bilsef/Teensy4.1-RAMPS/README.md

# Teensy4.1-RAMPS
 A Teensy 4.1 to RAMPS adapter board
