bilsef/Teensy4.1-RAMPS/Gerber/teensy4_ramps-bom.xlsx

Comment | Desisgnator | Footprint | LCSSC Part # | Description
100uF, 35V | C1 | C_Elec_6.3x7.7 | C134792 (https://lcsc.com/product-detail/Aluminum-Electrolytic-Capacitors-SMD_Lelon-VES101M1VTR-0607_C134792.html/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) | 100uF ±20% 35V SMD,6.3x7.7mm
100nF | C2, C3 | C_0402 | C1525 (https://lcsc.com/product-detail/Multilayer-Ceramic-Capacitors-MLCC-SMD-SMT_SAMSUNG_CL05B104KO5NNNC_100nF-104-10-16V_C1525.html/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) | MULTILAYER CERAMIC CAPACITORS MLCC - SMD/SMT 100NF 16V 0402 ROHS
18pF | C4 | C_0402 | C1549 (https://lcsc.com/product-detail/Multilayer-Ceramic-Capacitors-MLCC-SMD-SMT_18pF-180-5-50V_C1549.html/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) | MULTILAYER CERAMIC CAPACITORS MLCC - SMD/SMT 18PF 50V 0402 ROHS
22uF, 16V | C5 | CP_Elec_4x5.3 | C134793 (https://lcsc.com/product-detail/Aluminum-Electrolytic-Capacitors-SMD_Lelon-VES220M1CTR-0405_C134793.html/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) | 22UF ±20% 16V SMD,4X5.3MM ALUMINUM ELECTROLYTIC CAPACITORS - SMD ROHS
1uF | C6 | C_0402 | C52923 (https://lcsc.com/product-detail/Multilayer-Ceramic-Capacitors-MLCC-SMD-SMT_SAMSUNG_CL05A105KA5NQNC_1uF-105-10-25V_C52923.html/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) | MULTILAYER CERAMIC CAPACITORS MLCC - SMD/SMT 1UF 25V 0402 ROHS
1A SMA | D1 | D_SMA | C260338 (https://lcsc.com/product-detail/Diodes-General-Purpose_SMC-Sangdest-Microelectronicstronic-Nanjing-S1A_C260338.html/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) | 50V 1A 1.1V @ 1A SMA DIODES - GENERAL PURPOSE ROHS
BAT60AE6327 | D2 | D_SOD-323 | C117485 (https://lcsc.com/product-detail/Schottky-Barrier-Diodes-SBD_Infineon-Technologies-BAT60AE6327_C117485.html/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) | 10V 3A 370MV @ 1A SOD-323 SCHOTTKY BARRIER DIODES (SBD) ROHS
4.7uH | L1 | L_4.7x5.2 | C477170 (https://lcsc.com/product-detail/Inductors-SMD_Gantong-GPSR0530-4R7M_C477170.html/?href=jlc-SMT) | 4.7UH ±20% 3A 46MΩ SMD,4.7X5.2X3.0MM INDUCTORS (SMD) ROHS
49.9K | R1, R2 | R_0402 | C25897 (https://lcsc.com/product-detail/Chip-Resistor-Surface-Mount_Uniroyal-Elec-0402WGF4992TCE_C25897.html/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) | CHIP RESISTOR - SURFACE MOUNT 49.9KOHMS ±1% 1/16W 0402 ROHS
9.53K | R3 | R_0402 | C96273 (https://lcsc.com/product-detail/Chip-Resistor-Surface-Mount_Uniroyal-Elec-0402WGF9531TCE_C96273.html/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) | CHIP RESISTOR - SURFACE MOUNT 9.53KOHMS ±1% 1/16W 0402 ROHS
AOZ1280CI | U2 | SOT-23-6 | C41240 (https://lcsc.com/product-detail/DC-DC-Converters_AOS_aoz1280ci_aoz1280ci_C41240.html/?href=jlc-SMT) | DC-DC CONVERTERS STEP-DOWN ADJUSTABLE 1 3V 26V 0.8V 1.2A SOT-23-6 ROHS
