bilsef/Teensy4.1-RAMPS/teensy4_ramps.pdf

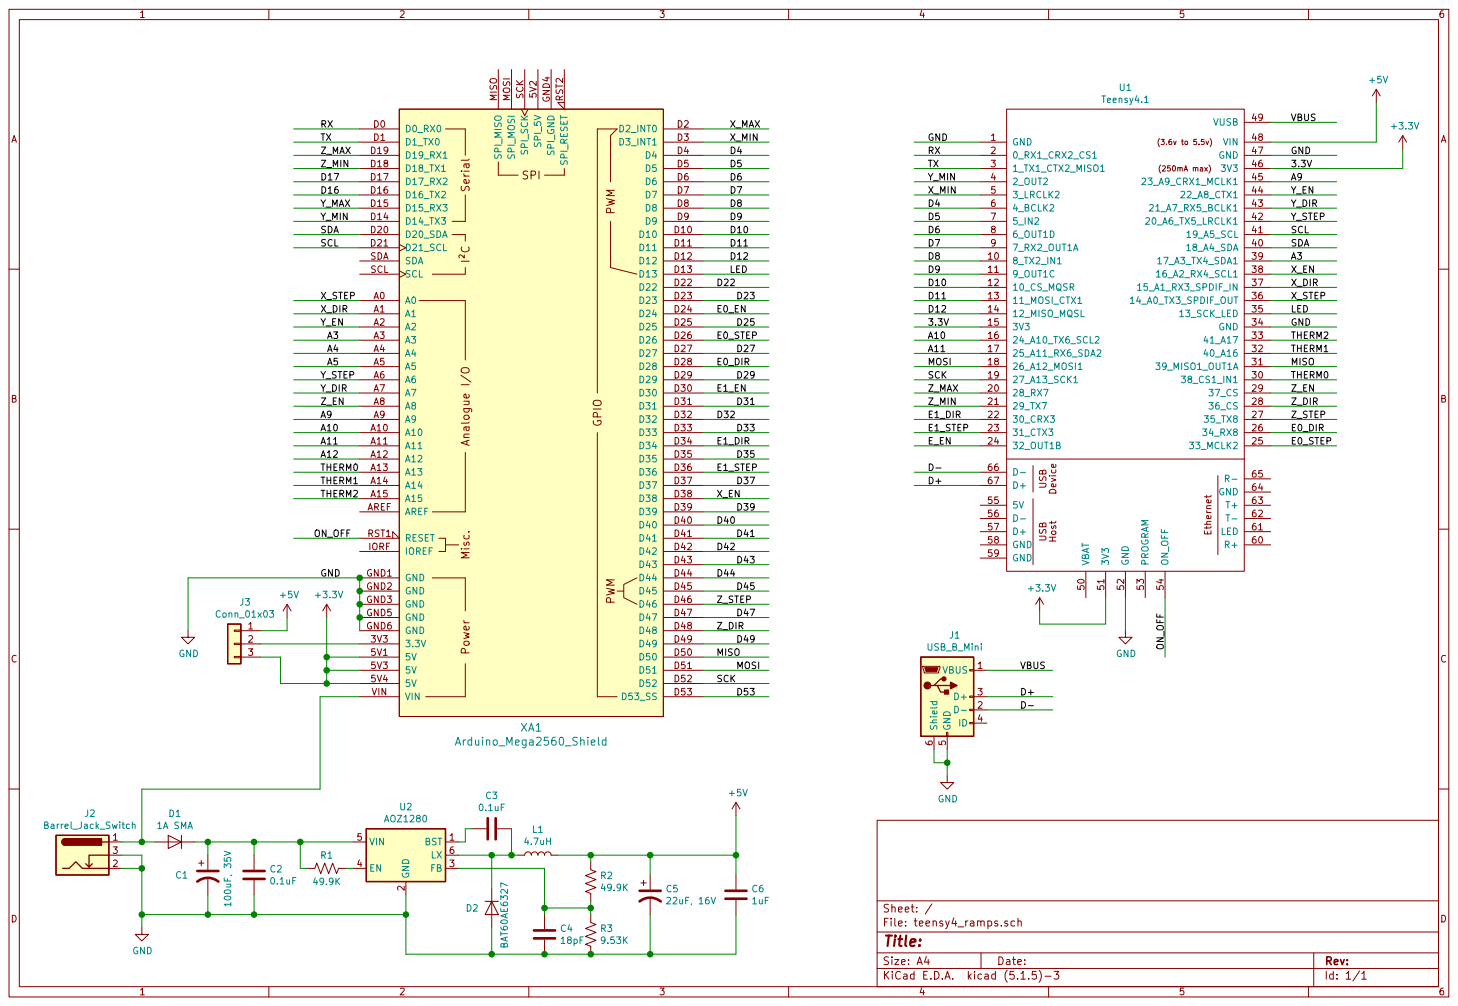
[picture p1: page 1]
