bilsef/Teensy4.1-RAMPS/teensy4_ramps.kicad_pcb

## KiCad design teensy4_ramps.kicad_pcb (2020-10-17)

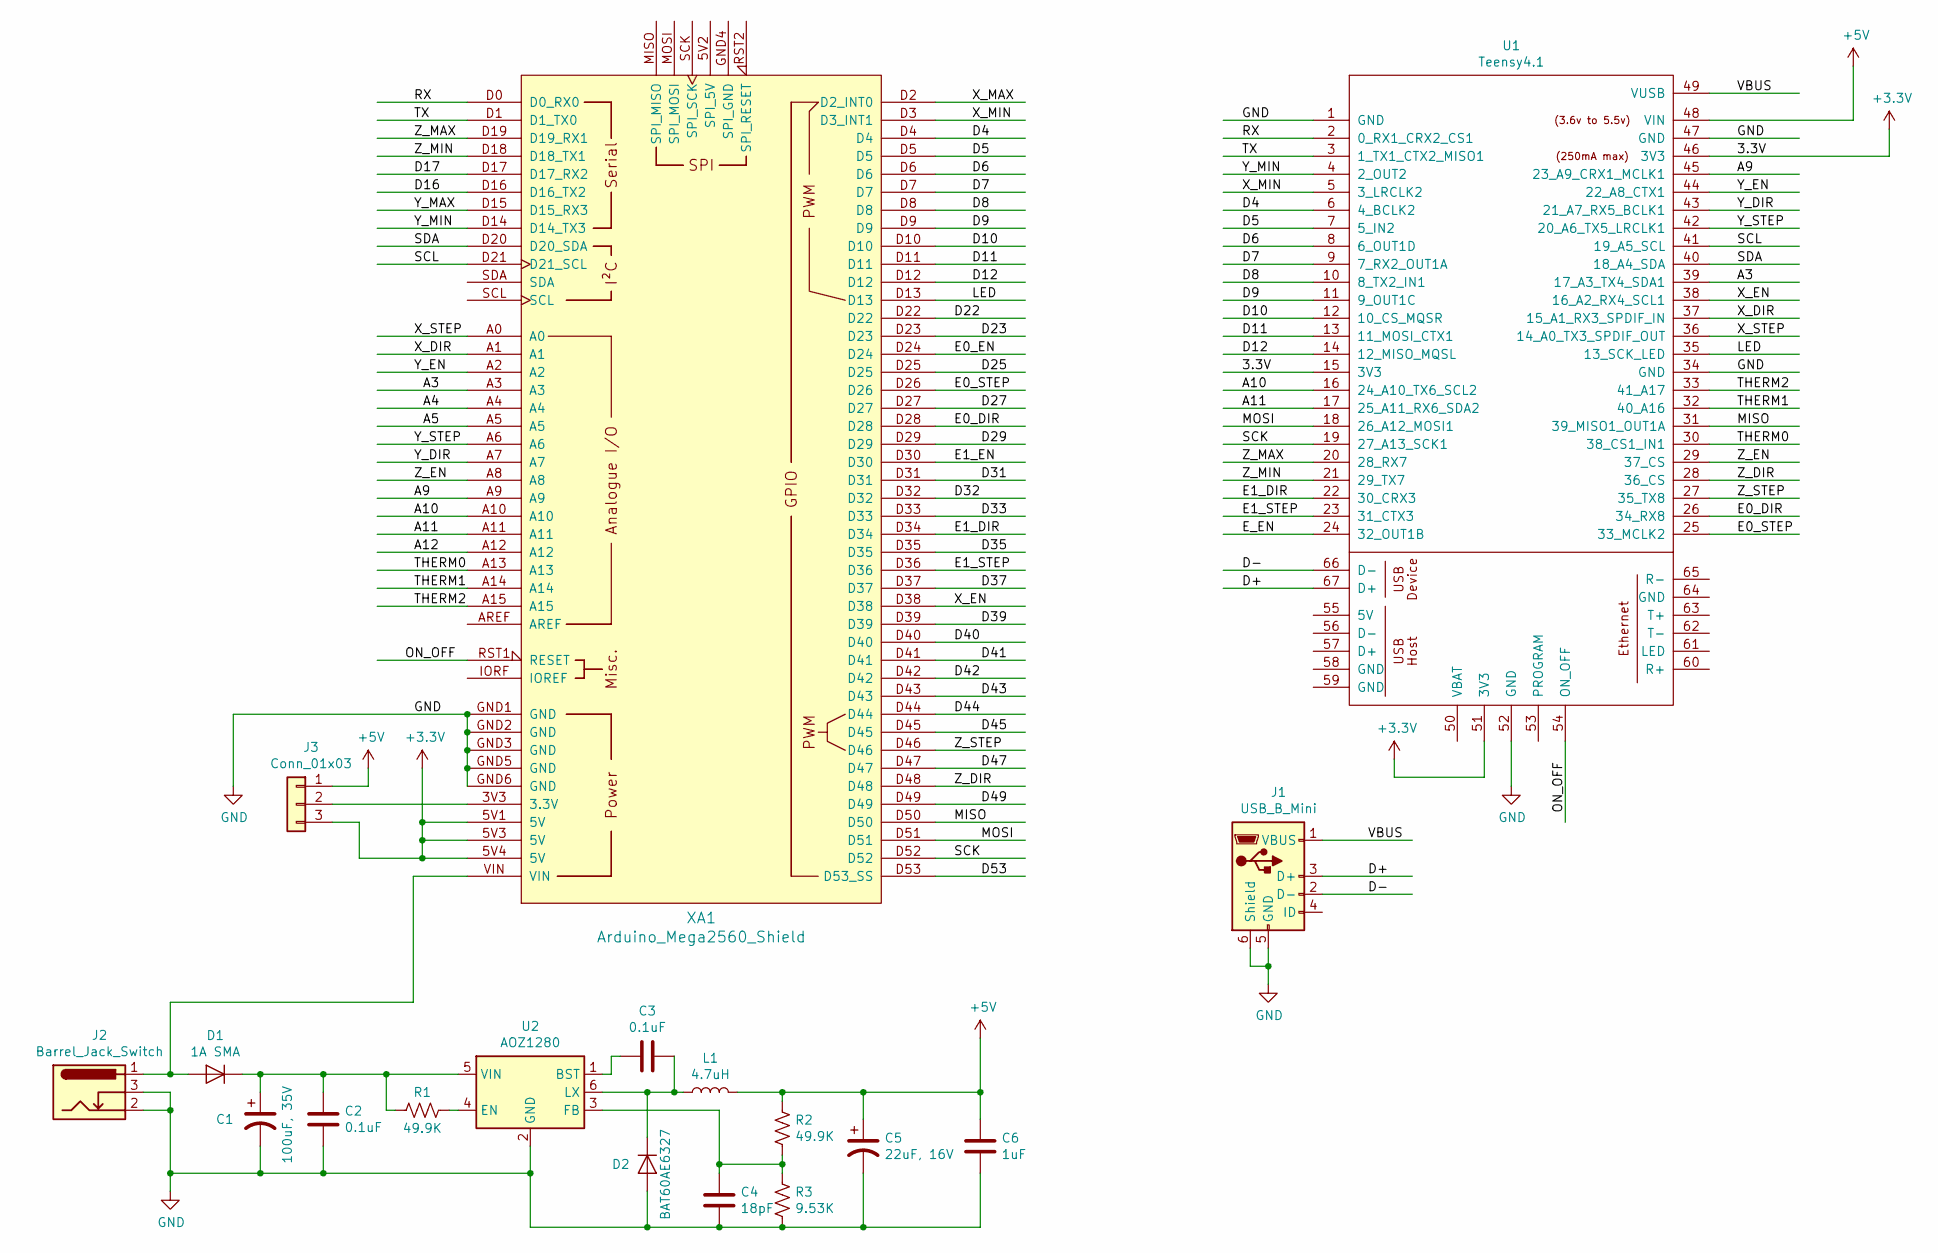
[picture p2: schematic teensy4_ramps.sch]

Parts:
C1: 100uF, 35V; C_Elec_6.3x7.7
C2, C3: 0.1uF; C_0402_1005Metric
C4: 18pF; C_0402_1005Metric
C5: 22uF, 16V; CP_Elec_4x5.3
C6: 1uF; C_0402_1005Metric
D1: 1A SMA; D_SMA
D2: BAT60AE6327; D_SOD-323
J1: USB_B_Mini; USB_Mini-B_Lumberg_2486_01_Horizontal
J2: Barrel_Jack_Switch; BarrelJack_Horizontal
J3: Conn_01x03; PinHeader_1x03_P2.54mm_Vertical
L1: 4.7uH; L_Taiyo-Yuden_NR-50xx
R1, R2: 49.9K; R_0402_1005Metric
R3: 9.53K; R_0402_1005Metric
U1: Teensy4.1; Teensy41
U2: AOZ1280; SOT-23-6
XA1: Arduino_Mega2560_Shield

Connections:
+3V3: J3.3, U1.15 (3V3), U1.46 (3V3), U1.51 (3V3), XA1.5V1 (5V), XA1.5V3 (5V), XA1.5V4 (5V)
+5V: C5.1, C6.1, J3.1, L1.2, R2.1, U1.48 (VIN)
/A3: U1.39 (17_A3_TX4_SDA1), XA1.A3
/A4: XA1.A4
/A5: XA1.A5
/A9: U1.45 (23_A9_CRX1_MCLK1), XA1.A9
/A10: U1.16 (24_A10_TX6_SCL2), XA1.A10
/A11: U1.17 (25_A11_RX6_SDA2), XA1.A11
/A12: XA1.A12
/D4: U1.6 (4_BCLK2), XA1.D4
/D5: U1.7 (5_IN2), XA1.D5
/D6: U1.8 (6_OUT1D), XA1.D6
/D7: U1.9 (7_RX2_OUT1A), XA1.D7
/D8: U1.10 (8_TX2_IN1), XA1.D8
/D9: U1.11 (9_OUT1C), XA1.D9
/D10: U1.12 (10_CS_MQSR), XA1.D10
/D11: U1.13 (11_MOSI_CTX1), XA1.D11
/D12: U1.14 (12_MISO_MQSL), XA1.D12
/D16: XA1.D16 (D16_TX2)
/D17: XA1.D17 (D17_RX2)
/D22: XA1.D22
/D23: XA1.D23
/D25: XA1.D25
/D27: XA1.D27
/D29: XA1.D29
/D31: XA1.D31
/D32: XA1.D32
/D33: XA1.D33
/D35: XA1.D35
/D37: XA1.D37
/D39: XA1.D39
/D40: XA1.D40
/D41: XA1.D41
/D42: XA1.D42
/D43: XA1.D43
/D44: XA1.D44
/D45: XA1.D45
/D47: XA1.D47
/D49: XA1.D49
/D53: XA1.D53 (D53_SS)
/D+: J1.3 (D+), U1.67 (D+)
/D-: J1.2 (D-), U1.66 (D-)
/E0_DIR: U1.26 (34_RX8), XA1.D28
/E0_EN: XA1.D24
/E0_STEP: U1.25 (33_MCLK2), XA1.D26
/E1_DIR: U1.22 (30_CRX3), XA1.D34
/E1_EN: XA1.D30
/E1_STEP: U1.23 (31_CTX3), XA1.D36
/E_EN: U1.24 (32_OUT1B)
/LED: U1.35 (13_SCK_LED), XA1.D13
/MISO: U1.31 (39_MISO1_OUT1A), XA1.D50
/MOSI: U1.18 (26_A12_MOSI1), XA1.D51
/ON_OFF: U1.54 (ON_OFF), XA1.RST1 (RESET)
/RX: U1.2 (0_RX1_CRX2_CS1), XA1.D0 (D0_RX0)
/SCK: U1.19 (27_A13_SCK1), XA1.D52
/SCL: U1.41 (19_A5_SCL), XA1.D21 (D21_SCL)
/SDA: U1.40 (18_A4_SDA), XA1.D20 (D20_SDA)
/THERM0: U1.30 (38_CS1_IN1), XA1.A13
/THERM1: U1.32 (40_A16), XA1.A14
/THERM2: U1.33 (41_A17), XA1.A15
/TX: U1.3 (1_TX1_CTX2_MISO1), XA1.D1 (D1_TX0)
/VBUS: J1.1 (VBUS), U1.49 (VUSB)
/X_DIR: U1.37 (15_A1_RX3_SPDIF_IN), XA1.A1
/X_EN: U1.38 (16_A2_RX4_SCL1), XA1.D38
/X_MAX: XA1.D2 (D2_INT0)
/X_MIN: U1.5 (3_LRCLK2), XA1.D3 (D3_INT1)
/X_STEP: U1.36 (14_A0_TX3_SPDIF_OUT), XA1.A0
/Y_DIR: U1.43 (21_A7_RX5_BCLK1), XA1.A7
/Y_EN: U1.44 (22_A8_CTX1), XA1.A2
/Y_MAX: XA1.D15 (D15_RX3)
/Y_MIN: U1.4 (2_OUT2), XA1.D14 (D14_TX3)
/Y_STEP: U1.42 (20_A6_TX5_LRCLK1), XA1.A6
/Z_DIR: U1.28 (36_CS), XA1.D48
/Z_EN: U1.29 (37_CS), XA1.A8
/Z_MAX: U1.20 (28_RX7), XA1.D19 (D19_RX1)
/Z_MIN: U1.21 (29_TX7), XA1.D18 (D18_TX1)
/Z_STEP: U1.27 (35_TX8), XA1.D46
GND: C1.2, C2.2, C4.2, C5.2, C6.2, D2.2 (A), J1.5 (GND), J1.6 (Shield), J2.2, J2.3, R3.2, U1.1 (GND), U1.34 (GND), U1.47 (GND), U1.52 (GND), U2.2 (GND), XA1.GND1 (GND), XA1.GND2 (GND), XA1.GND3 (GND), XA1.GND5 (GND), XA1.GND6 (GND)
unnamed: C1.1, C2.1, D1.1 (K), R1.2, U2.5 (VIN)
unnamed: C3.1, D2.1 (K), L1.1, U2.6 (LX)
unnamed: C3.2, U2.1 (BST)
unnamed: C4.1, R2.2, R3.1, U2.3 (FB)
unnamed: D1.2 (A), J2.1, XA1.VIN
unnamed: J3.2, XA1.3V3 (3.3V)
unnamed: R1.1, U2.4 (EN)

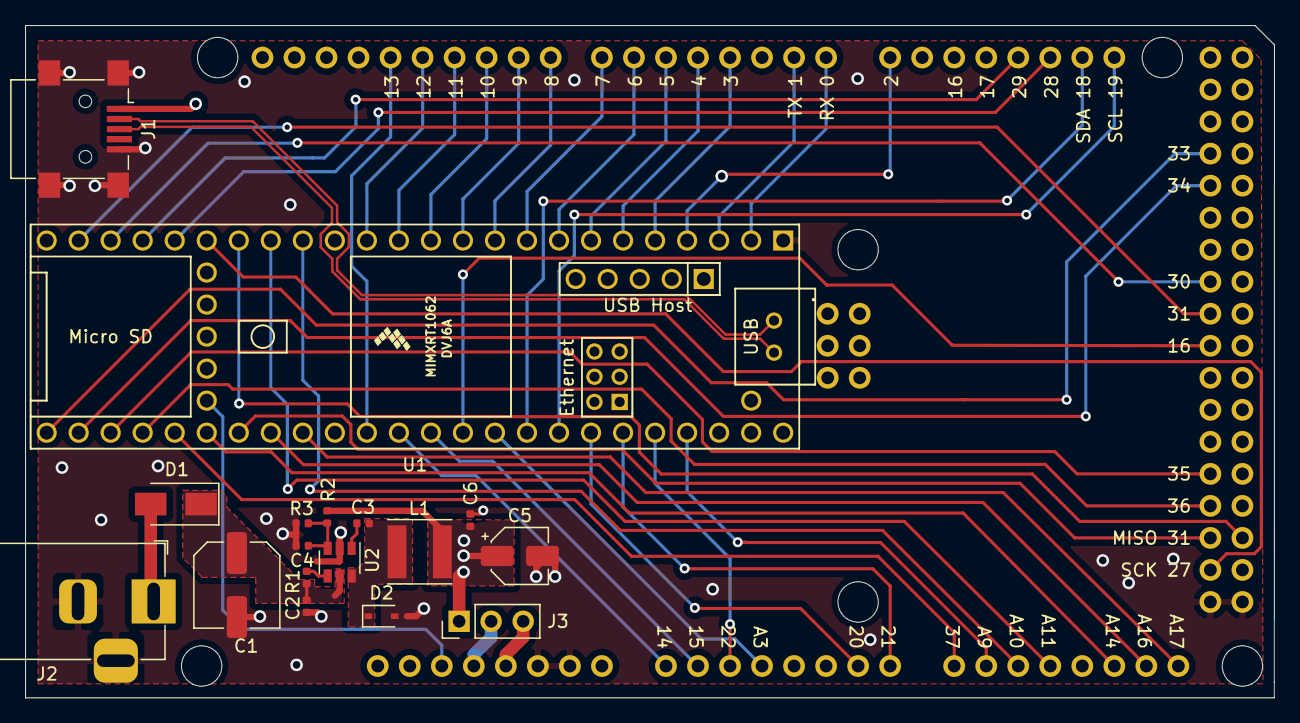
[picture p3: board teensy4_ramps.kicad_pcb from above]

Board: 4 copper layers, 99.1 x 53.3 mm, 18 parts (0 on the bottom side), 55 nets.
